CoreElectronics/CE-PiicoDev-Magnetometer-QMC6310/Documents/schematic.pdf

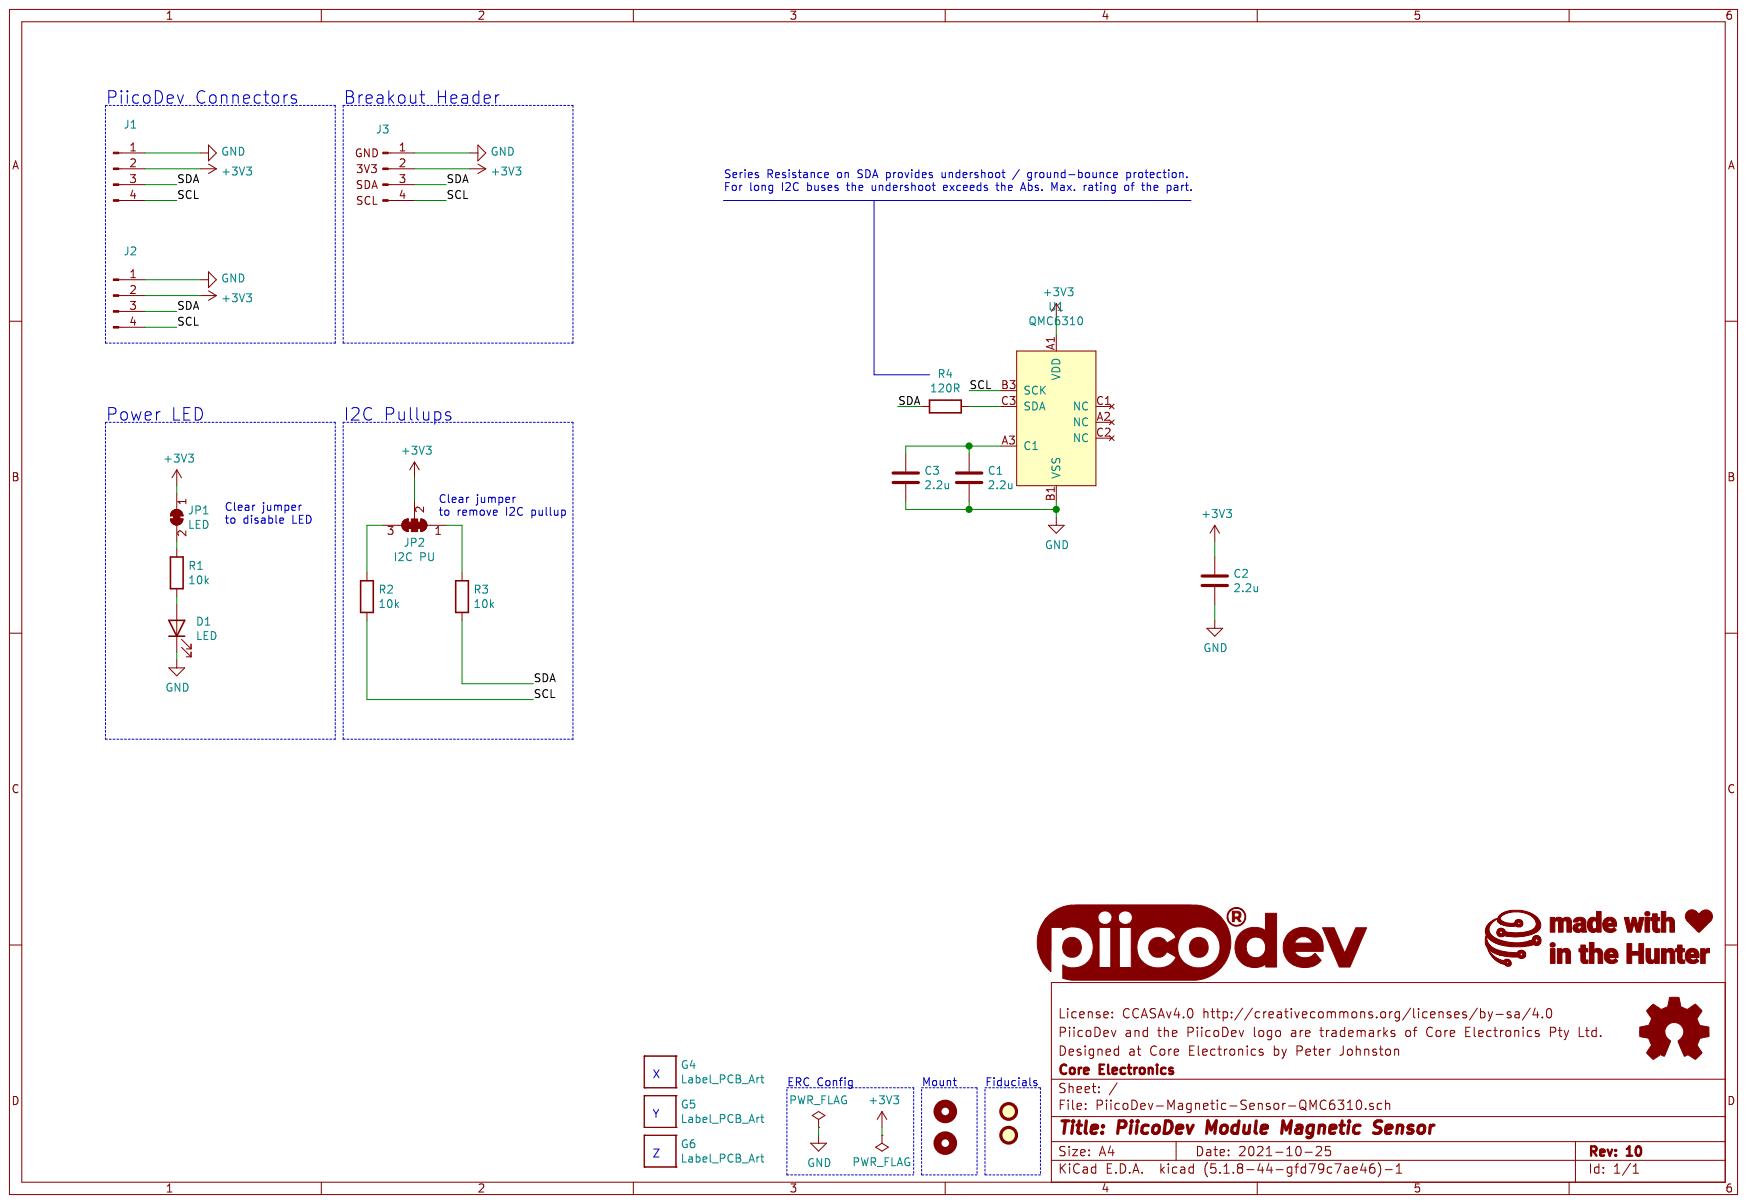
[picture p1: page 1]
