CoreElectronics/CE-PiicoDev-Magnetometer-QMC6310/(commit log)

2021-09-02 Change LED resistor to 4k7
    [PiicoDev-Magnetic-Sensor-QMC6310.sch]
2021-10-19 Updates
    Add axis on silk
    Increase the IC perimeter silk screen to ensure it doesn't interfere with the pad connections.
    [PiicoDev-Magnetic-Sensor-QMC6310.kicad_pcb, PiicoDev-Magnetic-Sensor-QMC6310.sch]
2021-10-27 Add 120R SDA resistor
    [PiicoDev-Magnetic-Sensor-QMC6310.kicad_pcb, PiicoDev-Magnetic-Sensor-QMC6310.sch]
2021-11-18 Change 4.7k resistors to 10k
    [PiicoDev-Magnetic-Sensor-QMC6310.kicad_pcb, PiicoDev-Magnetic-Sensor-QMC6310.sch]
2022-03-02 add comment for 120R SDA resistor
    [PiicoDev-Magnetic-Sensor-QMC6310.sch]
2022-05-04 Update schematic for KiCad 6
    [PiicoDev-Magnetic-Sensor-QMC6310.kicad_sch]
