CoreElectronics/CE-PiicoDev-Magnetometer-QMC6310/(notices)

Notices in the files:
PCB/PiicoDev-Magnetic-Sensor-QMC6310.sch:
License: CCASAv4.0 http://creativecommons.org/licenses/by-sa/4.0
